YasinC4342/BLE-MacroPad/README.md

# Description
The MacroPad is a general use macro keypad, designed for ECAD, CAD, Photoshop, Blender and many other professionnal softwares. Its purpose is to make multiple combinations within one click, so shortcuts (ex : CTRL + ALT + SHIFT or simply write lots of words). It will be working on both BLE and USB HID.

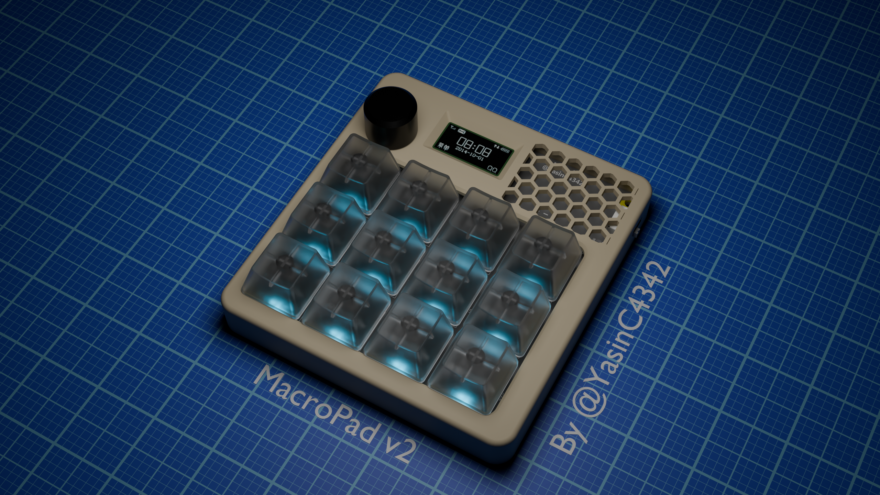
[picture p1: screenshots/rendered.png]


# Why i made this ?

My goal was to make 3D models quickly for the customers who needs it earlier than expected, and also for blender if i ever forgot of which combination i use for making a Bezel for example. Since i have a compact keyboard (about 60-65%), i needed more keys without sacrificing my workspace and also to put it on the side of the desk when i doesn't need it. Anyway, here is my first prototype (i cannot 3d print parts now because I am in the process of moving but as soon as possible) :
Link : [**https://wokwi.com/projects/478323132743048193**](https://wokwi.com/projects/478323132743048193)

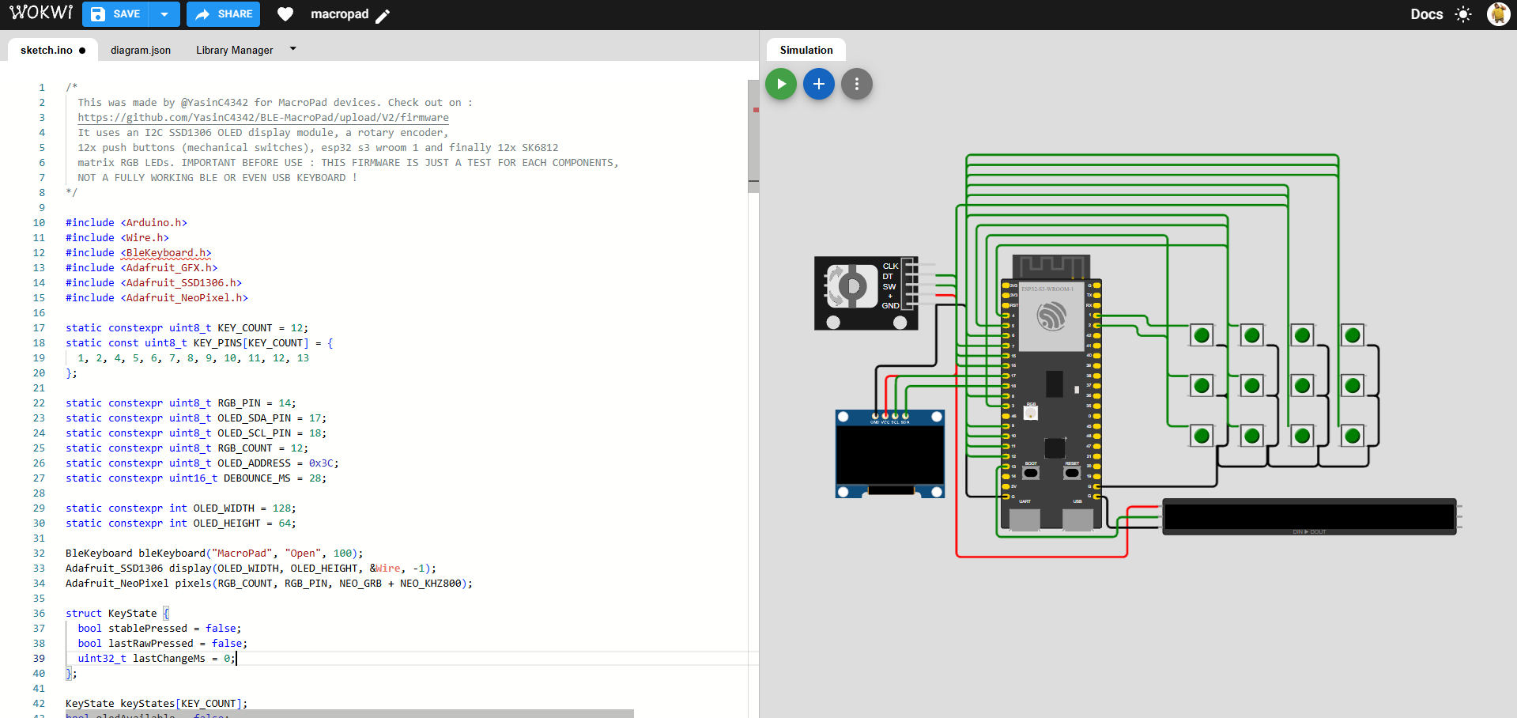
[picture p2: screenshots/prototype.png]


For information, i used examples of the libraries and merge all the examples in one code (with adjustements of course) to see if it works. Unfortunately, i don't own any esp32 but making simulations on Wowki or Tinkercad, so no bluetooth or usb, just basic testing.
 
# Features
- O.96inch OLED display
- 12 adressable RGB LEDs
- 3x4 Cherry MX switches
- USB type C
- Obviously works on bluetooth and USB HID
- A rotary encoder for controling volume with ease, for example.

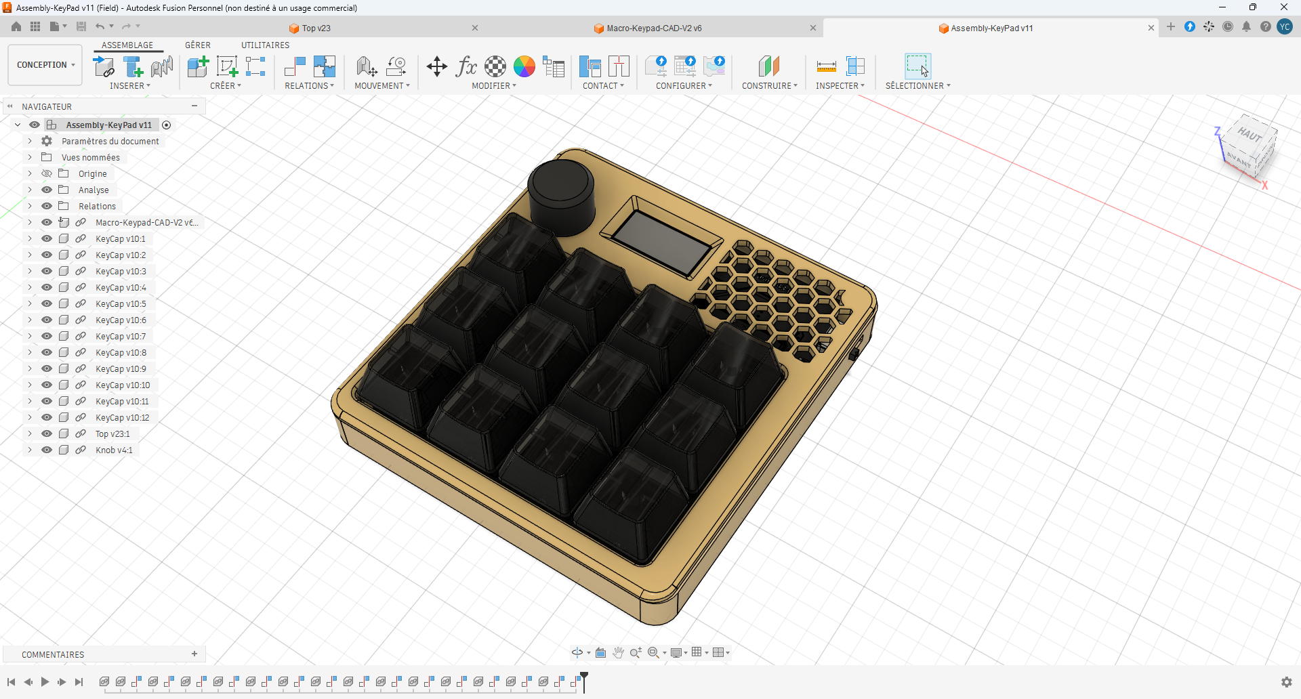
[picture p3: screenshots/cad.png]

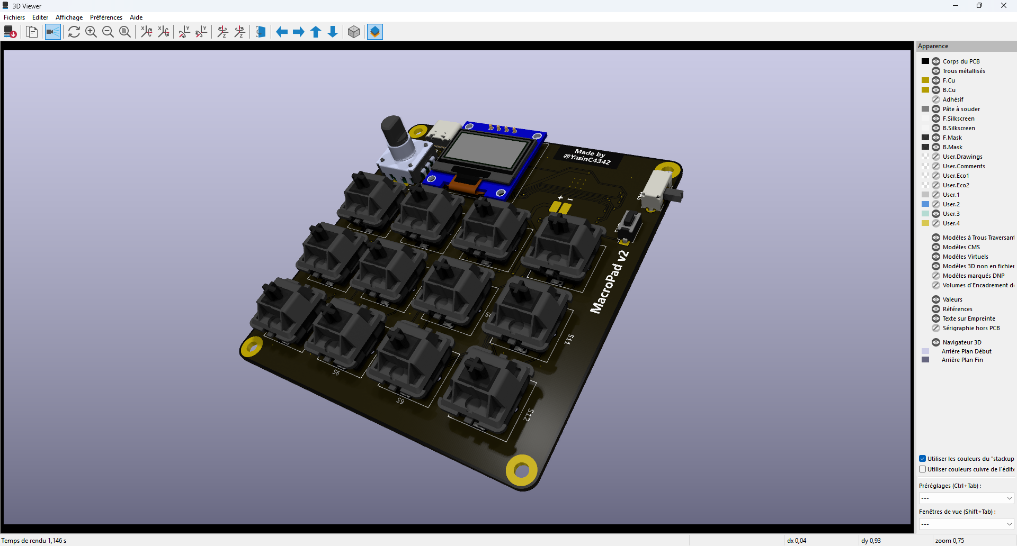
[picture p4: screenshots/pcb.png]

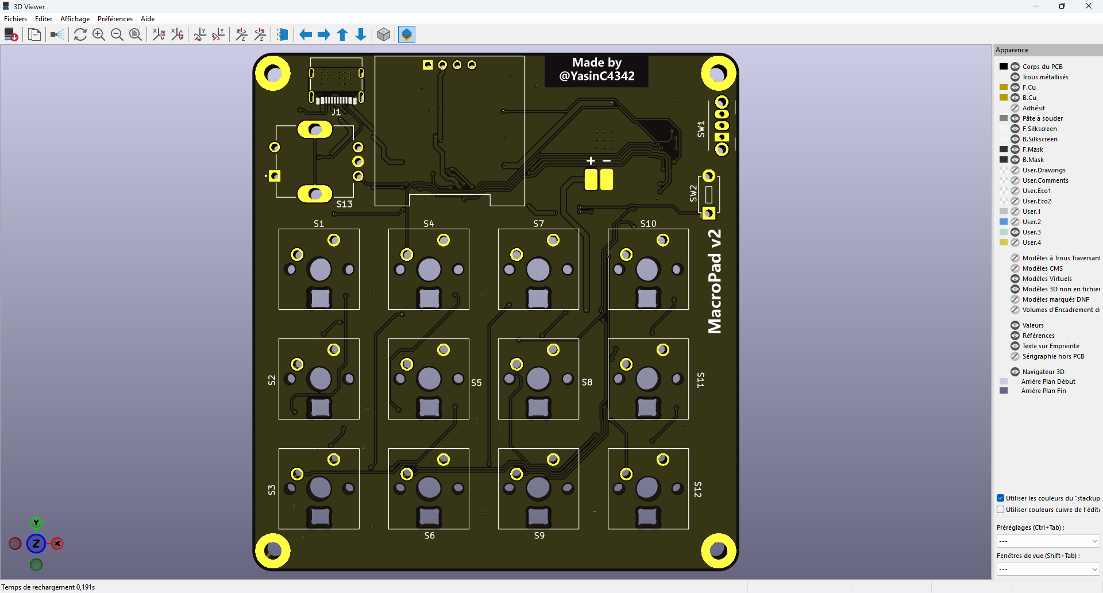
[picture p5: screenshots/front.png]

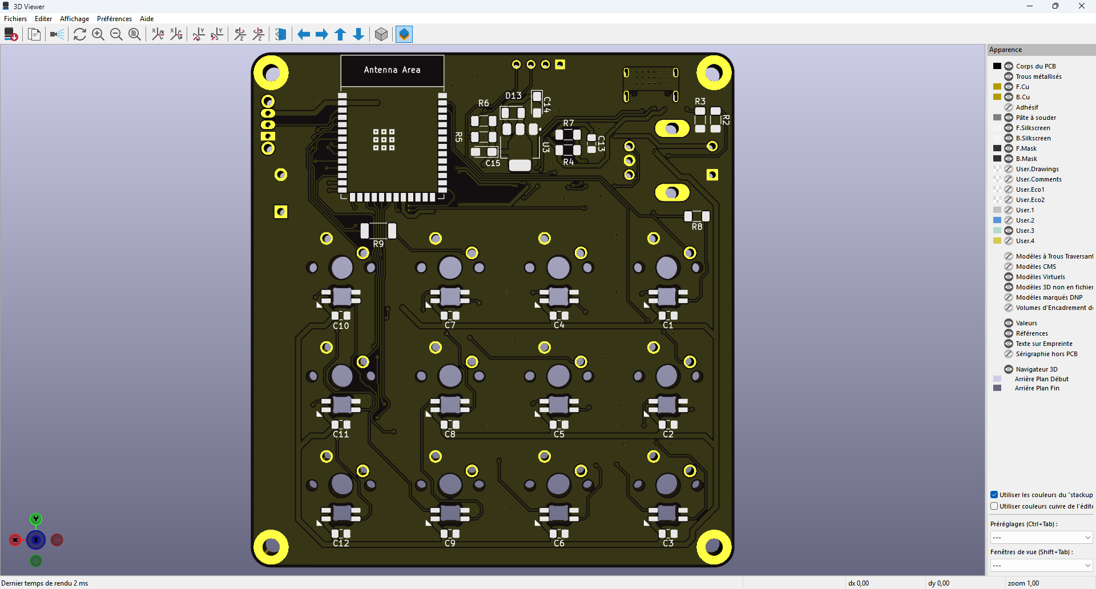
[picture p6: screenshots/back.png]


# Requirements
The required components are down below :

| ID | Reference | Designation | Quantity | Value | Price EUR  | Supplier | Links |
|----|---|---|---|---|---|---|---|
| 1  | C1, C2, C3, C4, C5, C6, C7, C8, C9, C10, C11, C12 | 0805 SMD Capacitor | 12 | 0.1uF | 1,8 € | Aliexpress | [Link](https://www.aliexpress.com/item/1005012588693858.html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)  |
| 2  | C13 | 0805 SMD Capacitor | 1 | 10uF | 1,8 € | Aliexpress | [Link](https://www.aliexpress.com/item/1005012588693858.html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)  |
| 3  | C14 | Tantalum Capacitor, Kemet-A | 1 | 10uF | 1,32 € | Aliexpress | [Link](https://www.aliexpress.com/item/32698733093.html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) |
| 4  | C15 | Tantalum Capacitor, Kemet-A | 1 | 22uF | 1,59 € | Aliexpress | [Link](https://www.aliexpress.com/item/32698733093.html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) |
| 5  | D1, D2, D3, D4, D5, D6, D7, D8, D9, D10, D11, D12 | SK6812 Mini Reversed SMD RGB LEDs | 12 | SK6812 | 4,39 € | Aliexpress | [Link](https://www.aliexpress.com/item/1005005186515165.html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)  |
| 6  | D13 | 1206 SMD Diode | 1 | Diode | - | Aliexpress | **Already own the component** |
| 7  | J1 | USB-C Female connector 12 pin | 1 | USB_C_female_14P | 2,18 € | Aliexpress | [Link](https://www.aliexpress.com/item/1005005371954812.html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)  |
| 8  | R1 | 1206 SMD Resistor | 1 | 470R | 0,95 € | Aliexpress | [Link](https://www.aliexpress.com/item/1005012304341288.html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)  |
| 9  | R2, R3, R5, R6 | 1206 SMD Resistor | 4 | 5.1K | 0,95 € | Aliexpress | [Link](https://www.aliexpress.com/item/1005012304341288.html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)  |
| 10 | R4 | 1206 SMD Resistor | 1 | 10K | 0,95 € | Aliexpress | [Link](https://www.aliexpress.com/item/1005012304341288.html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)  |
| 11 | R7 | 1206 SMD Resistor | 1 | 1.8K | 0,95 € | Aliexpress | [Link](https://www.aliexpress.com/item/1005012304341288.html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)  |
| 12 | R9 | 2010 SMD Resistor | 1 | 0R | - | Aliexpress | **Already own the component** |
| 13 | S1, S2, S3, S4, S5, S6, S7, S8, S9, S10, S11, S12 | Cherry MX1A-11NA Switches | 12 | MX1A-11NA | 5,30 € | Aliexpress | [Link](https://www.aliexpress.com/item/1005008089864080.html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)  |
| 14 | S13 | PEC11R Rotary encoder | 1 | PEC12R_Encoder | 3,99 € | Aliexpress | [Link](https://www.aliexpress.com/item/1005007391341287.html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) |
| 15 | SW1 | SPDT Slide switch | 1 | SW_SPDT | - | Aliexpress | **Already own the component** |
| 16 | SW2 | Push button 6x3.5mm | 1 | SW_Push | 3,59 € | Aliexpress | [Link](https://www.aliexpress.com/item/1005007177692594.html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)  |
| 17 | U1 | ESP32-S3-WROOM-1 | 1 | ESP32-S3-WROOM-1 | 6,59 € | Aliexpress | [Link](https://www.aliexpress.com/item/1005009314619102.html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)  |
| 18 | U2 | 0.96" OLED Display module | 1 | 0,96"  OLED Module | 2,56 € | Aliexpress | [Link](https://www.aliexpress.com/item/1005006141235306.html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)  |
| 20 | PCB | Main PCB | 1 | PCB | 3,57 € | Aliexpress | [Link](https://cart.jlcpcb.com/fr/quote?spm=jlcpcb.Public.2006) 
| **Total** | **43,88 €** | **49,24 $** |

**AI Disclosure:**
During this project, I used AI to help with debugging KiCad DRC errors and to assist in writing firmware, and to check if my circuit is fine WITHOUT listing any components, just giving me advice and i did on my own and figured out later.

For 3d parts, I wiil 3d print them, so not included in the list of shipping or buying.

# Downloads
Download the complete hardware design package from the [**v2.0.0 Release**](https://github.com/YasinC4342/BLE-MacroPad/releases/tag/v2.0.0).
