YasinC4342/BLE-MacroPad/screenshots/cart-1.png

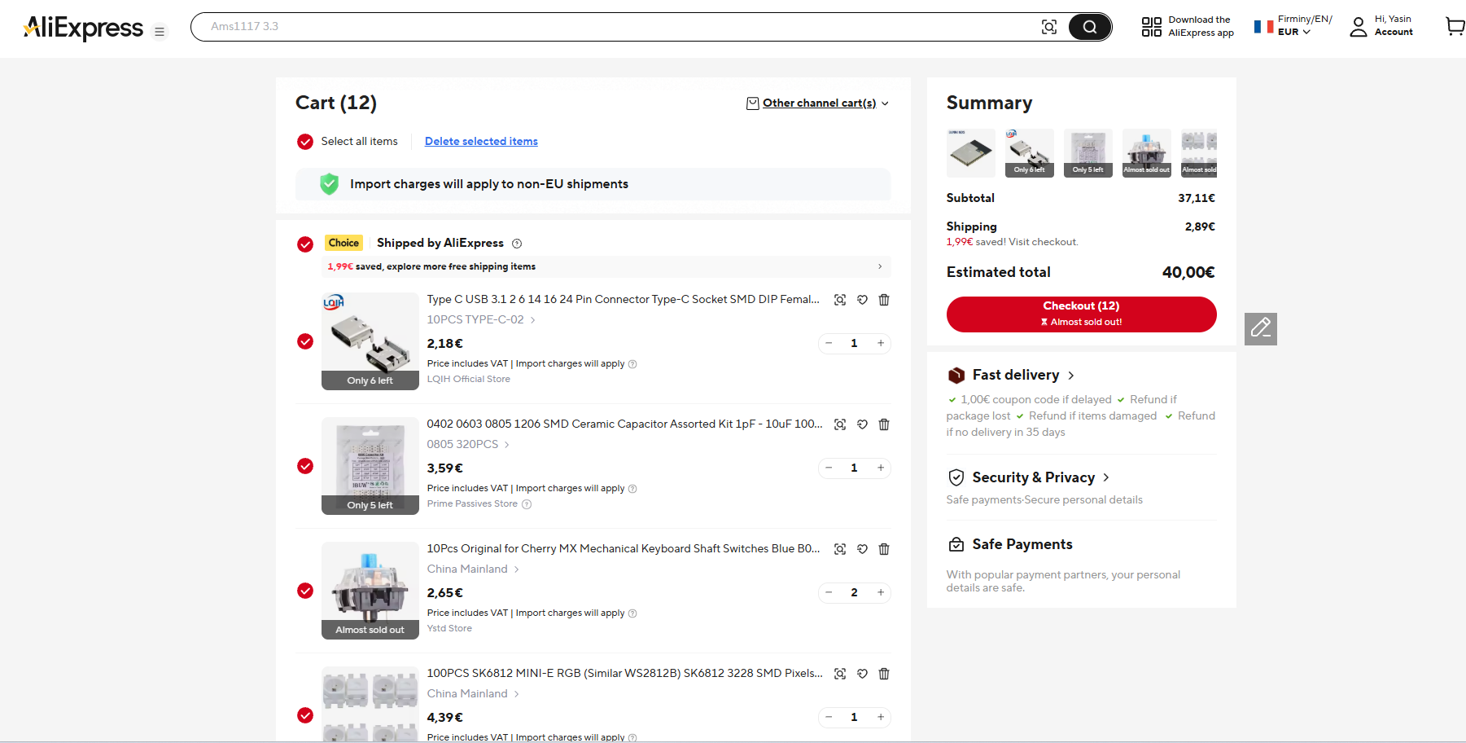
screenshots/cart-1.png
