YasinC4342/BLE-MacroPad/screenshots/cart-2.png

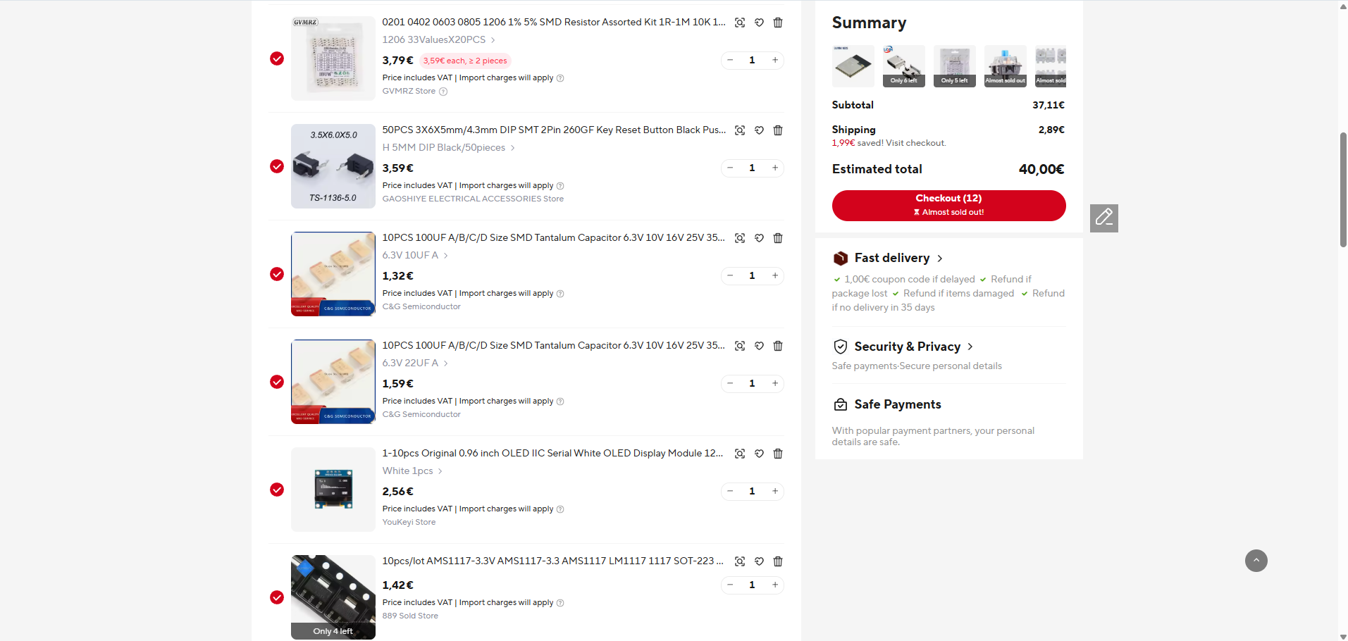
screenshots/cart-2.png
