YasinC4342/BLE-MacroPad/screenshots/cart-3.png

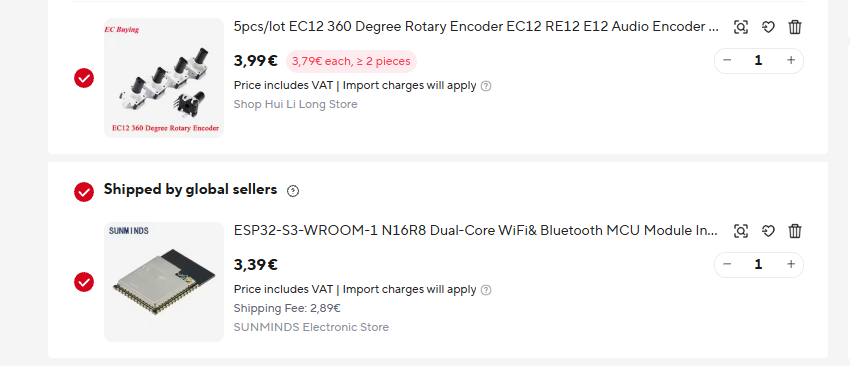
screenshots/cart-3.png
