YasinC4342/BLE-MacroPad/screenshots/DRC.png

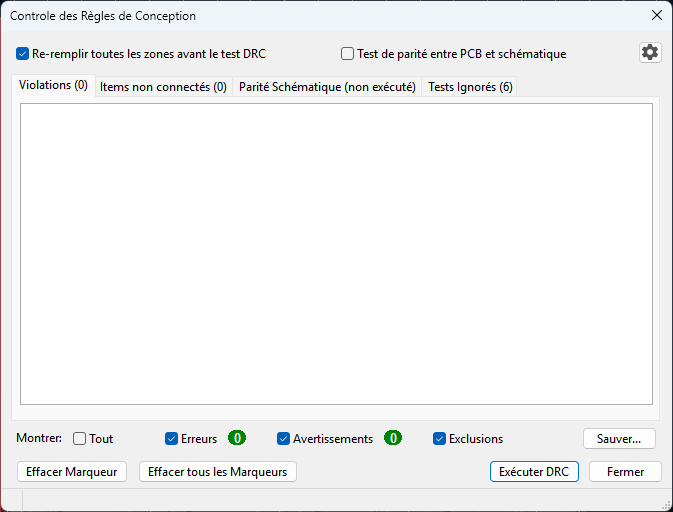
screenshots/DRC.png
