YasinC4342/BLE-MacroPad/screenshots/ERC.png

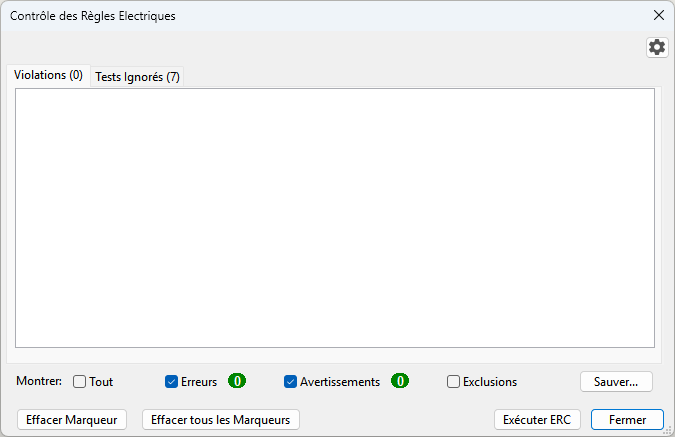
screenshots/ERC.png
