YasinC4342/BLE-MacroPad/screenshots/release.png

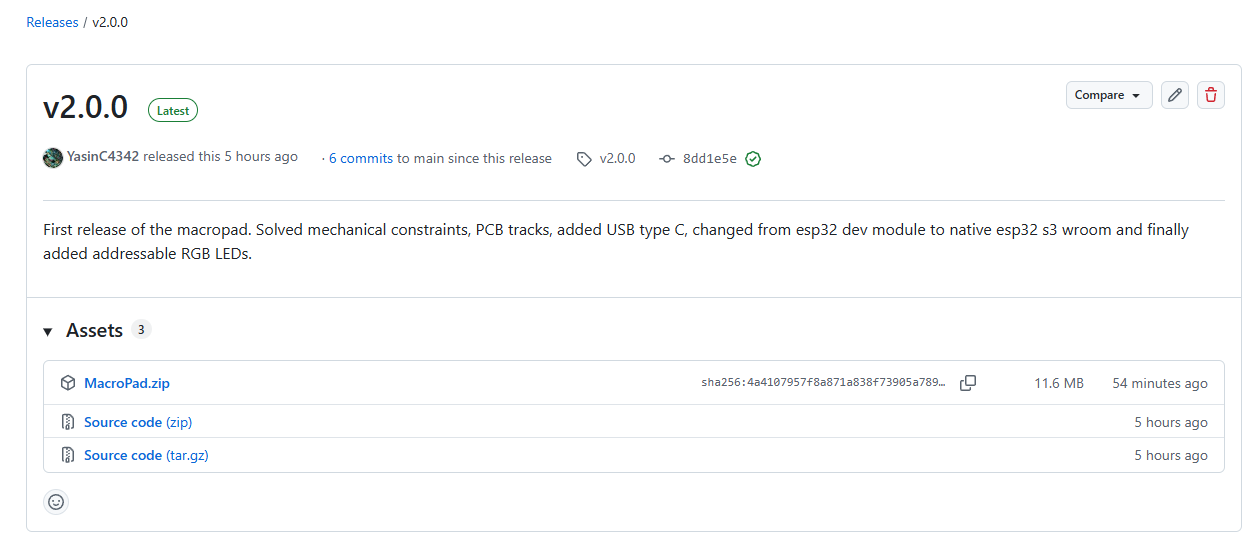
screenshots/release.png
