YasinC4342/BLE-MacroPad/screenshots/schematic.png

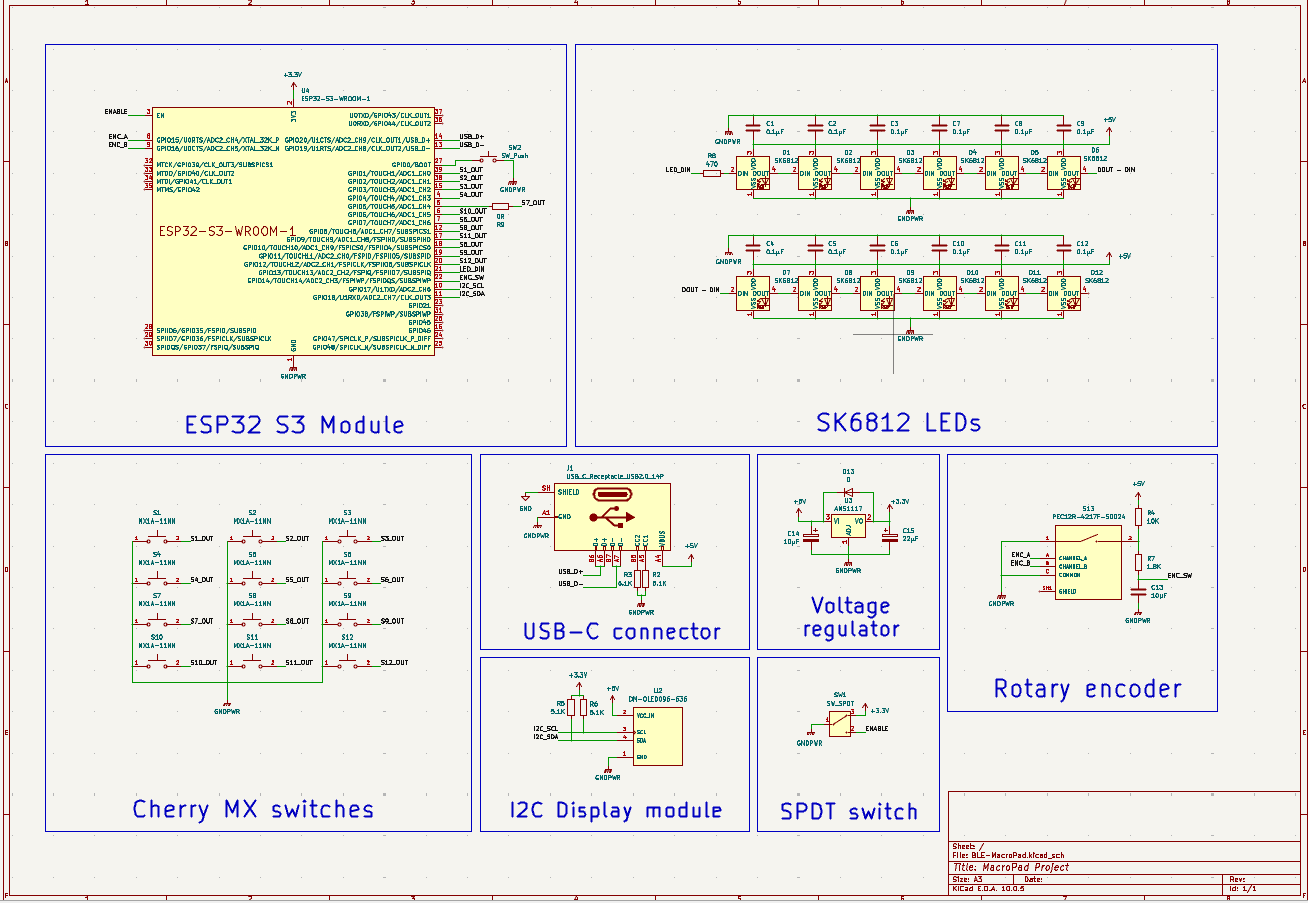
screenshots/schematic.png
