YasinC4342/BLE-MacroPad/screenshots/shop.png

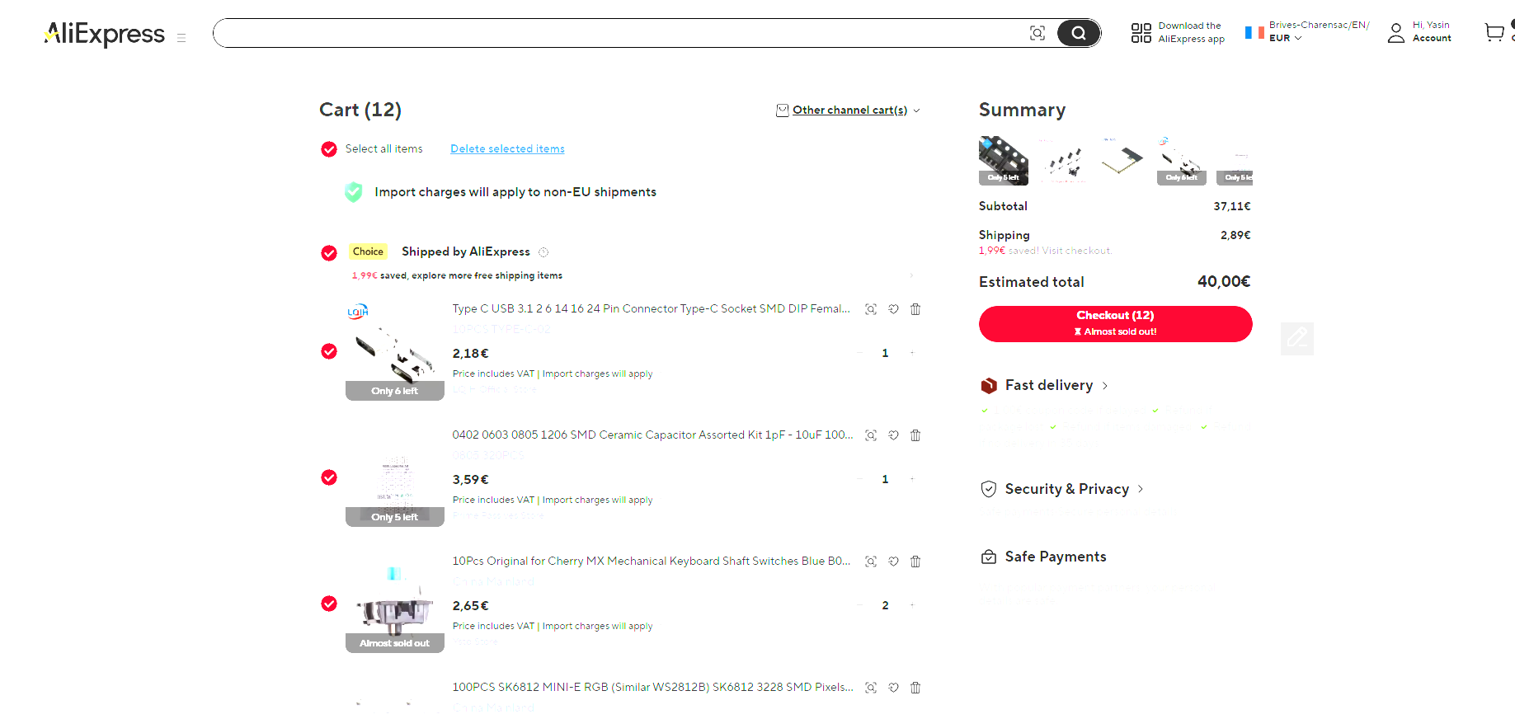
screenshots/shop.png
