YasinC4342/BLE-MacroPad/BOM.csv

ID | Reference | Designation | Quantity | Value | Price EUR | Supplier | Links
1 | C1, C2, C3, C4, C5, C6, C7, C8, C9, C10, C11, C12 | 0805 SMD Capacitor | 12 | 0.1uF | 1,8 € | Aliexpress | https://www.aliexpress.com/item/1005012588693858.html?mp=1
2 | C13 | 0805 SMD Capacitor | 1 | 10uF | 1,8 € | Aliexpress | https://www.aliexpress.com/item/1005012588693858.html?mp=1
3 | C14 | Tantalum Capacitor, Kemet-A | 1 | 10uF | 1,32 € | Aliexpress | https://www.aliexpress.com/item/32698733093.html?mp=1
4 | C15 | Tantalum Capacitor, Kemet-A | 1 | 22uF | 1,59 € | Aliexpress | https://www.aliexpress.com/item/32698733093.html?mp=1
5 | D1, D2, D3, D4, D5, D6, D7, D8, D9, D10, D11, D12 | SK6812 Mini Reversed SMD RGB LEDs | 12 | SK6812 | 4,39 € | Aliexpress | https://www.aliexpress.com/item/1005005186515165.html?mp=1
6 | D13 | 1206 SMD Diode | 1 | Diode | - | Aliexpress | Already own the component
7 | J1 | USB-C Female connector 12 pin | 1 | USB_C_female_14P | 2,18 € | Aliexpress | https://www.aliexpress.com/item/1005005371954812.html?mp=1
8 | R1 | 1206 SMD Resistor | 1 | 470R | 0,95 € | Aliexpress | https://www.aliexpress.com/item/1005012304341288.html?mp=1
9 | R2, R3, R5, R6 | 1206 SMD Resistor | 4 | 5.1K | 0,95 € | Aliexpress | https://www.aliexpress.com/item/1005012304341288.html?mp=1
10 | R4 | 1206 SMD Resistor | 1 | 10K | 0,95 € | Aliexpress | https://www.aliexpress.com/item/1005012304341288.html?mp=1
11 | R7 | 1206 SMD Resistor | 1 | 1.8K | 0,95 € | Aliexpress | https://www.aliexpress.com/item/1005012304341288.html?mp=1
12 | R9 | 2010 SMD Resistor | 1 | 0R | - | Aliexpress | Already own the component
13 | S1, S2, S3, S4, S5, S6, S7, S8, S9, S10, S11, S12 | Cherry MX1A-11NA Switches | 12 | MX1A-11NA | 5,30 € | Aliexpress | https://www.aliexpress.com/item/1005008089864080.html?mp=1
14 | S13 | PEC11R Rotary encoder | 1 | PEC12R_Encoder | 3,99 € | Aliexpress | https://www.aliexpress.com/item/1005007391341287.html?mp=1
15 | SW1 | SPDT Slide switch | 1 | SW_SPDT | - | Aliexpress | Already own the component
16 | SW2 | Push button 6x3.5mm | 1 | SW_Push | 3,59 € | Aliexpress | https://www.aliexpress.com/item/1005007177692594.html?mp=1
17 | U1 | ESP32-S3-WROOM-1 | 1 | ESP32-S3-WROOM-1 | 6,59 € | Aliexpress | https://www.aliexpress.com/item/1005009314619102.html?mp=1
18 | U2 | 0.96" OLED Display module | 1 | 0,96" OLED Module | 2,56 € | Aliexpress | https://www.aliexpress.com/item/1005006141235306.html?mp=1
20 | PCB | Main PCB | 1 | PCB | 3,57 € | Aliexpress | https://cart.jlcpcb.com/fr/quote?spm=jlcpcb.Public.2006
TOTAL | 43,88 € | 49,24 $
