YasinC4342/BLE-MacroPad/list-of-components.xlsx

ID | Reference | Footprint | Quantity | Designation | Price Euro | Links | TOTAL Euro
1 | C1, C2, C3, C4, C5, C6, C7, C8, C9, C10, C11, C12 | C_0805_2012Metric_Pad1.18x1.45mm_HandSolder | 12 | 0.1uF | 1.795 | https://www.aliexpress.com/item/1005012588693858.html?mp=1 | 40.31
2 | C13 | C_0805_2012Metric_Pad1.18x1.45mm_HandSolder | 1 | 10uF | 1.795 | https://www.aliexpress.com/item/1005012588693858.html?mp=1 | 0 euro = already have components
3 | C14 | CP_EIA-3216-18_Kemet-A_HandSolder | 1 | 10uF | 1.32 | https://www.aliexpress.com/item/32698733093.html?mp=1
4 | C15 | CP_EIA-3216-18_Kemet-A_HandSolder | 1 | 22uF | 1.59 | https://www.aliexpress.com/item/32698733093.html?mp=1 | PCB : 3,57 euro
5 | D1, D2, D3, D4, D5, D6, D7, D8, D9, D10, D11, D12 | MX_SK6812MINI-E | 12 | SK6812 | 4.39 | https://www.aliexpress.com/item/1005005186515165.html?mp=1
6 | D13 | D_1206_3216Metric | 1 | Diode | 0
7 | J1 | USB_C_Receptacle_Palconn_UTC16-G | 1 | USB_C_female_14P | 2.18 | https://www.aliexpress.com/item/1005005371954812.html?mp=1
8 | R1 | R_1206_3216Metric_Pad1.30x1.75mm_HandSolder | 1 | 470R | 0.9475 | https://www.aliexpress.com/item/1005012304341288.html?mp=1
9 | R2, R3, R5, R6 | R_1206_3216Metric_Pad1.30x1.75mm_HandSolder | 4 | 5.1K | 0.9475
10 | R4 | R_1206_3216Metric_Pad1.30x1.75mm_HandSolder | 1 | 10K | 0.9475
11 | R7 | R_1206_3216Metric_Pad1.30x1.75mm_HandSolder | 1 | 1.8K | 0.9475
12 | R9 | R_2010_5025Metric_Pad1.40x2.65mm_HandSolder | 1 | 0R | 0
13 | S1, S2, S3, S4, S5, S6, S7, S8, S9, S10, S11, S12 | SW_Cherry_MX_1.00u_PCB | 12 | MX1A-11NA | 5.3 | https://www.aliexpress.com/item/1005008089864080.html?mp=1
14 | S13 | XDCR_PEC12R-4217F-S0024 | 1 | PEC12R_Encoder | 3.99 | https://www.aliexpress.com/item/1005007391341287.html?mp=1
15 | SW1 | SW_Slide_SPDT_Angled_CK_OS102011MA1Q | 1 | SW_SPDT | 0
16 | SW2 | SW_PUSH_1P1T_6x3.5mm_H5.0_APEM_MJTP1250 | 1 | SW_Push | 3.59 | https://www.aliexpress.com/item/1005007177692594.html?mp=1
17 | U1 | ESP32-S3-WROOM-1 | 1 | ESP32-S3-WROOM-1 | 6.59 | https://www.aliexpress.com/item/1005009314619102.html?mp=1
18 | U2 | MODULE_DM-OLED096-636 | 1 | 0,96" OLED Module | 2.56 | https://www.aliexpress.com/item/1005006141235306.html?mp=1
19 | U3 | SOT-223-3_TabPin2 | 1 | AMS1117-3.3 | 1.42 | https://www.aliexpress.com/item/1005007500541919.html?mp=1
