YasinC4342/BLE-MacroPad/screenshots/bom.png

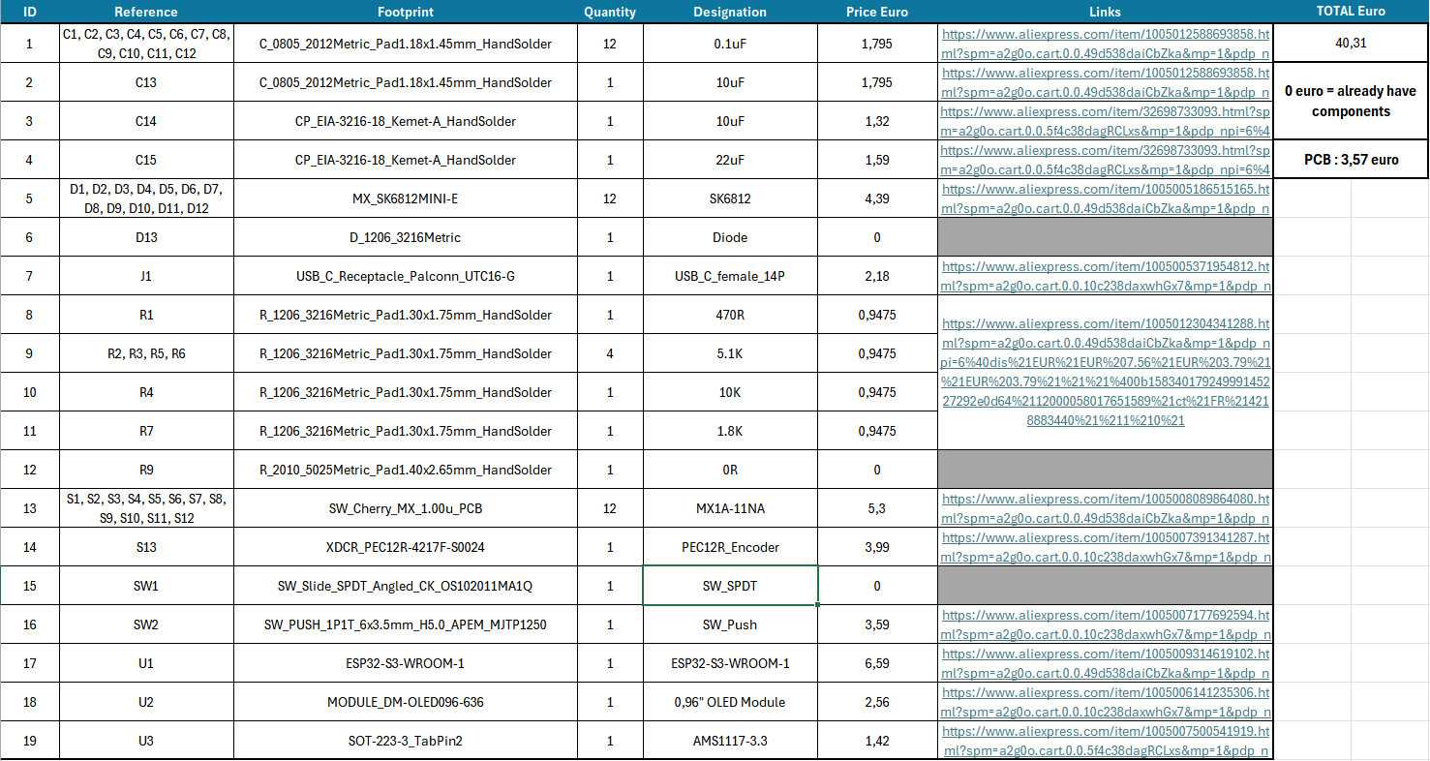
screenshots/bom.png
