YasinC4342/BLE-MacroPad/CAD/Top.step

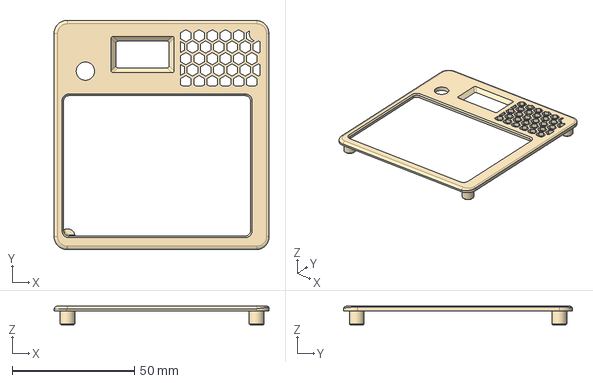
[picture p16: CAD file, 2026-10-17]
CAD/Top.step
88.0 x 93.9 x 7.70 mm
