YasinC4342/BLE-MacroPad/CAD/Base.step

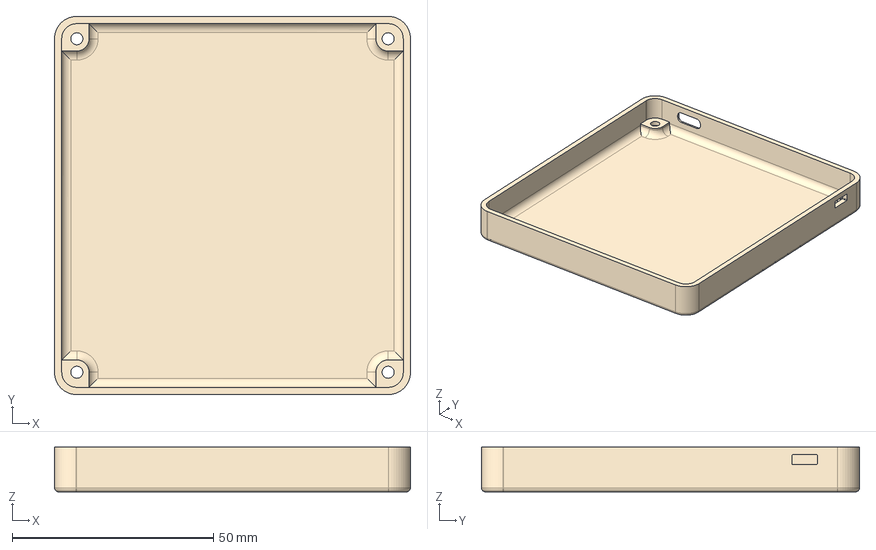
[picture p17: CAD file, 2026-10-17]
CAD/Base.step
88.5 x 94.0 x 11.1 mm
