YasinC4342/BLE-MacroPad/CAD/Knob.step

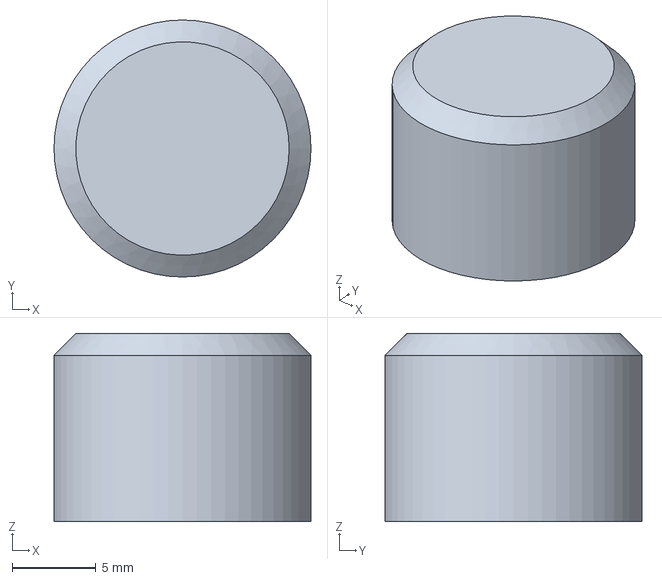
[picture p18: CAD file, 2026-10-17]
CAD/Knob.step
15.3 x 15.3 x 11.2 mm
