YasinC4342/BLE-MacroPad/CAD/BLE-MacroPad.step

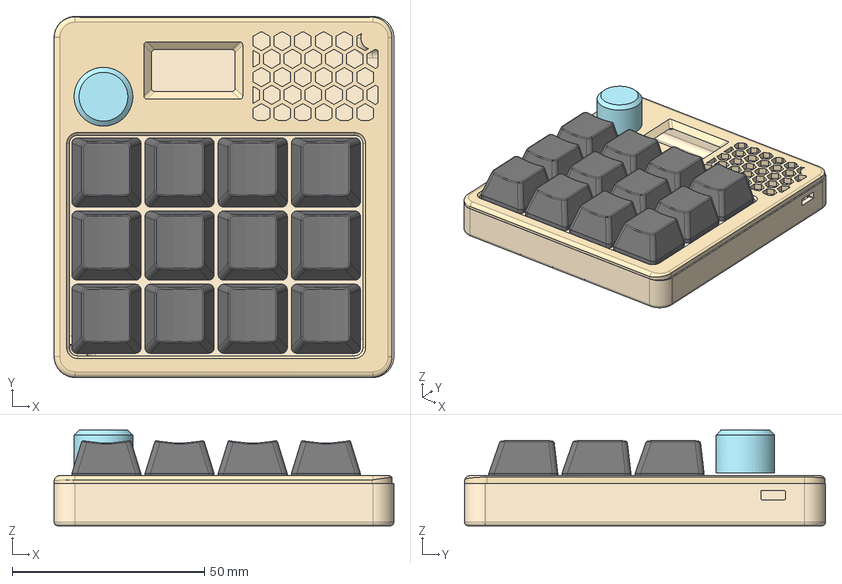
[picture p19: CAD file, 2026-10-17]
CAD/BLE-MacroPad.step
88.5 x 94.0 x 24.9 mm
Macro-Keypad-CAD-V2
KeyCap x 12
Top
Knob
