YasinC4342/BLE-MacroPad/(list of files, cad)

Other CAD files:
CAD/BLE-MacroPad.f3z
CAD/BLE-MacroPad.stl
CAD/Base.stl
CAD/Knob.stl
CAD/Top.stl
