YasinC4342/BLE-MacroPad/screenshots/manufacture.png

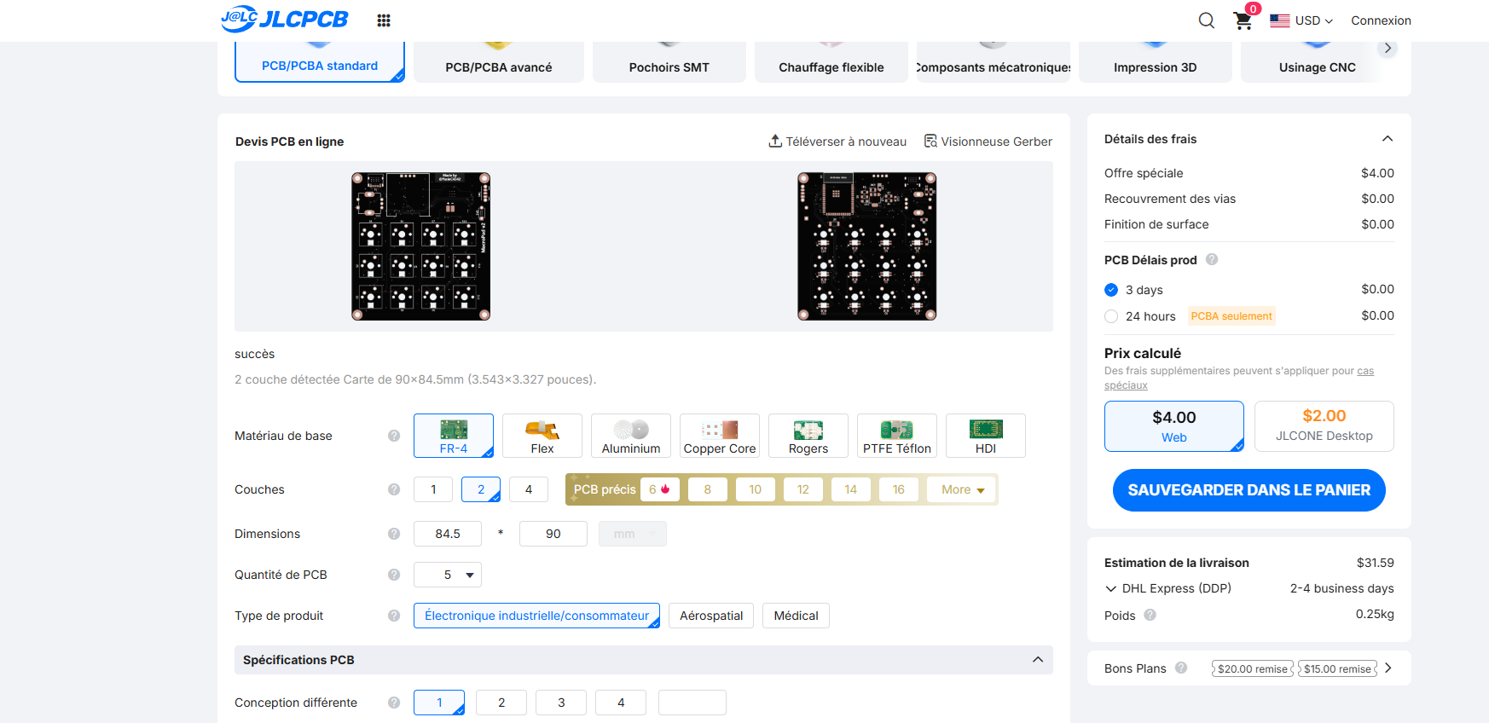
screenshots/manufacture.png
