YasinC4342/BLE-MacroPad/JOURNAL.md

---
title: "BLE-MacroPad"
github: "https://github.com/YasinC4342/BLE-MacroPad"
description: "A custom Bluetooth macro keypad for CAD, ECAD, and professional software."
created_at: "2026-10-17"
total_time: "13h 6m"
---

# BLE-MacroPad — Project Journal

The MacroPad is a general use macro keypad, designed for ECAD, CAD, Photoshop, Blender and many other professionnal softwares. Its purpose is to make multiple combinations within one click, so shortcuts (ex : CTRL + ALT + SHIFT or simply write lots of words). It will be working on both BLE and USB HID.

# October 1, 2026: PCB Design in KiCad
<!-- fabricate:entry 758 -->

I made the PCB in KiCad, integrating the ESP32-S3-WROOM-1 module, mechanical switches, RGB LEDs, OLED display module, and USB-C connector, with the PCB dimension of about 75 × 77 mm. ERC and DRC checks passed successfully.
I added a keepout zone around the ESP32 antenna area to reduce EMI, perturbating noises and also for better Bluetooth cover range, helped from documentations of Espressif. My goal was to fit all the components into a compact PCB to make it portable, not taking the majority of the workspace, keep the antenna's edge on the edge cuts of the PCB, chose differents tracks width and for only 2 layers if a problem appears.

**Images**








**Total time spent: 4h 48m**

# October 6, 2026: Mechanical Design and Component Layout
<!-- fabricate:entry 759 -->

I designed the macro keypad 3D model in Fusion 360, integrating 12 keys in a 3×4 layout, an OLED display, RGB LEDs, and a USB Type-C connector.
I imported the .STEP of the PCB and used the tool "Project" to see the exact measurements. But one big problem is that i needed to update it a lot because of the tolerance, which is +- 0.2-0.3, and the spacing between the 3d model's hole for fitting keys and the keycaps. So i used constraints and made it much easier !

I chose Fusion 360 as a CAD software because it's for makers (my thoughts), i have lots of experiences since i love learning some makers softwares and so inspired to them, 
like Abrège : [**https://www.youtube.com/@Abr%C3%A8ge**](https://www.youtube.com/@Abr%C3%A8ge).

**Images**




**Total time spent: 3h**

# October 14, 2026: Preparing the Manufacturing Files
<!-- fabricate:entry 760 -->

I prepared the manufacturing files into a zip for release v2.0.0 on GitHub, including Gerber file, BOM, and mechanical exports. So i exported the Gerber and BOM from KiCAD and tested on JLCPCB to see the 3d/2d view of the pcb and detection of the pcb, and of course i choose the cheapest delivery method to fit in my budget from 29$ to 4$ total. I chose black mask and white silkscreen to make it professionnal, remarquable and also to make it look like modern and newest design. All the files are ready, organised in the main directory and BOM updated, and I will publish the documentation of the product when received, assembled and tested.

**Project release**

[BLE-MacroPad v2.0.0 — Manufacturing Package](https://github.com/YasinC4342/BLE-MacroPad/releases/tag/v2.0.0)

**Images**




**Total time spent: 30m**

# October 20, 2026: Component Cost Optimization
<!-- fabricate:entry 761 -->

After realising that the project exceeds the max amount of 50$, I updated the BOM to reduce cost and stay in the 50$ budget (tier 4). The ESP32-S3-WROOM-2 was too expensive, so I decided to replace it and instead choose the ESP32-S3-WROOM-1 N16R8, more affordable in Aliexpress. After those changes, I updated the PCB footprint / symbol, replacing it, and checked the tracks (routing), antenna area and positionning, and ERC/DRC results before generating the final manufacturing files. And so this costs at a total amount of about 49$, including shipping and all of those stuffs, which i will round it to 50$.

**Images**






**Total time spent: 4h 48m**
