YasinC4342/BLE-MacroPad/PCB/BLE-MacroPad.kicad_pcb

## KiCad design PCB/BLE-MacroPad.kicad_pcb (2026-10-20)

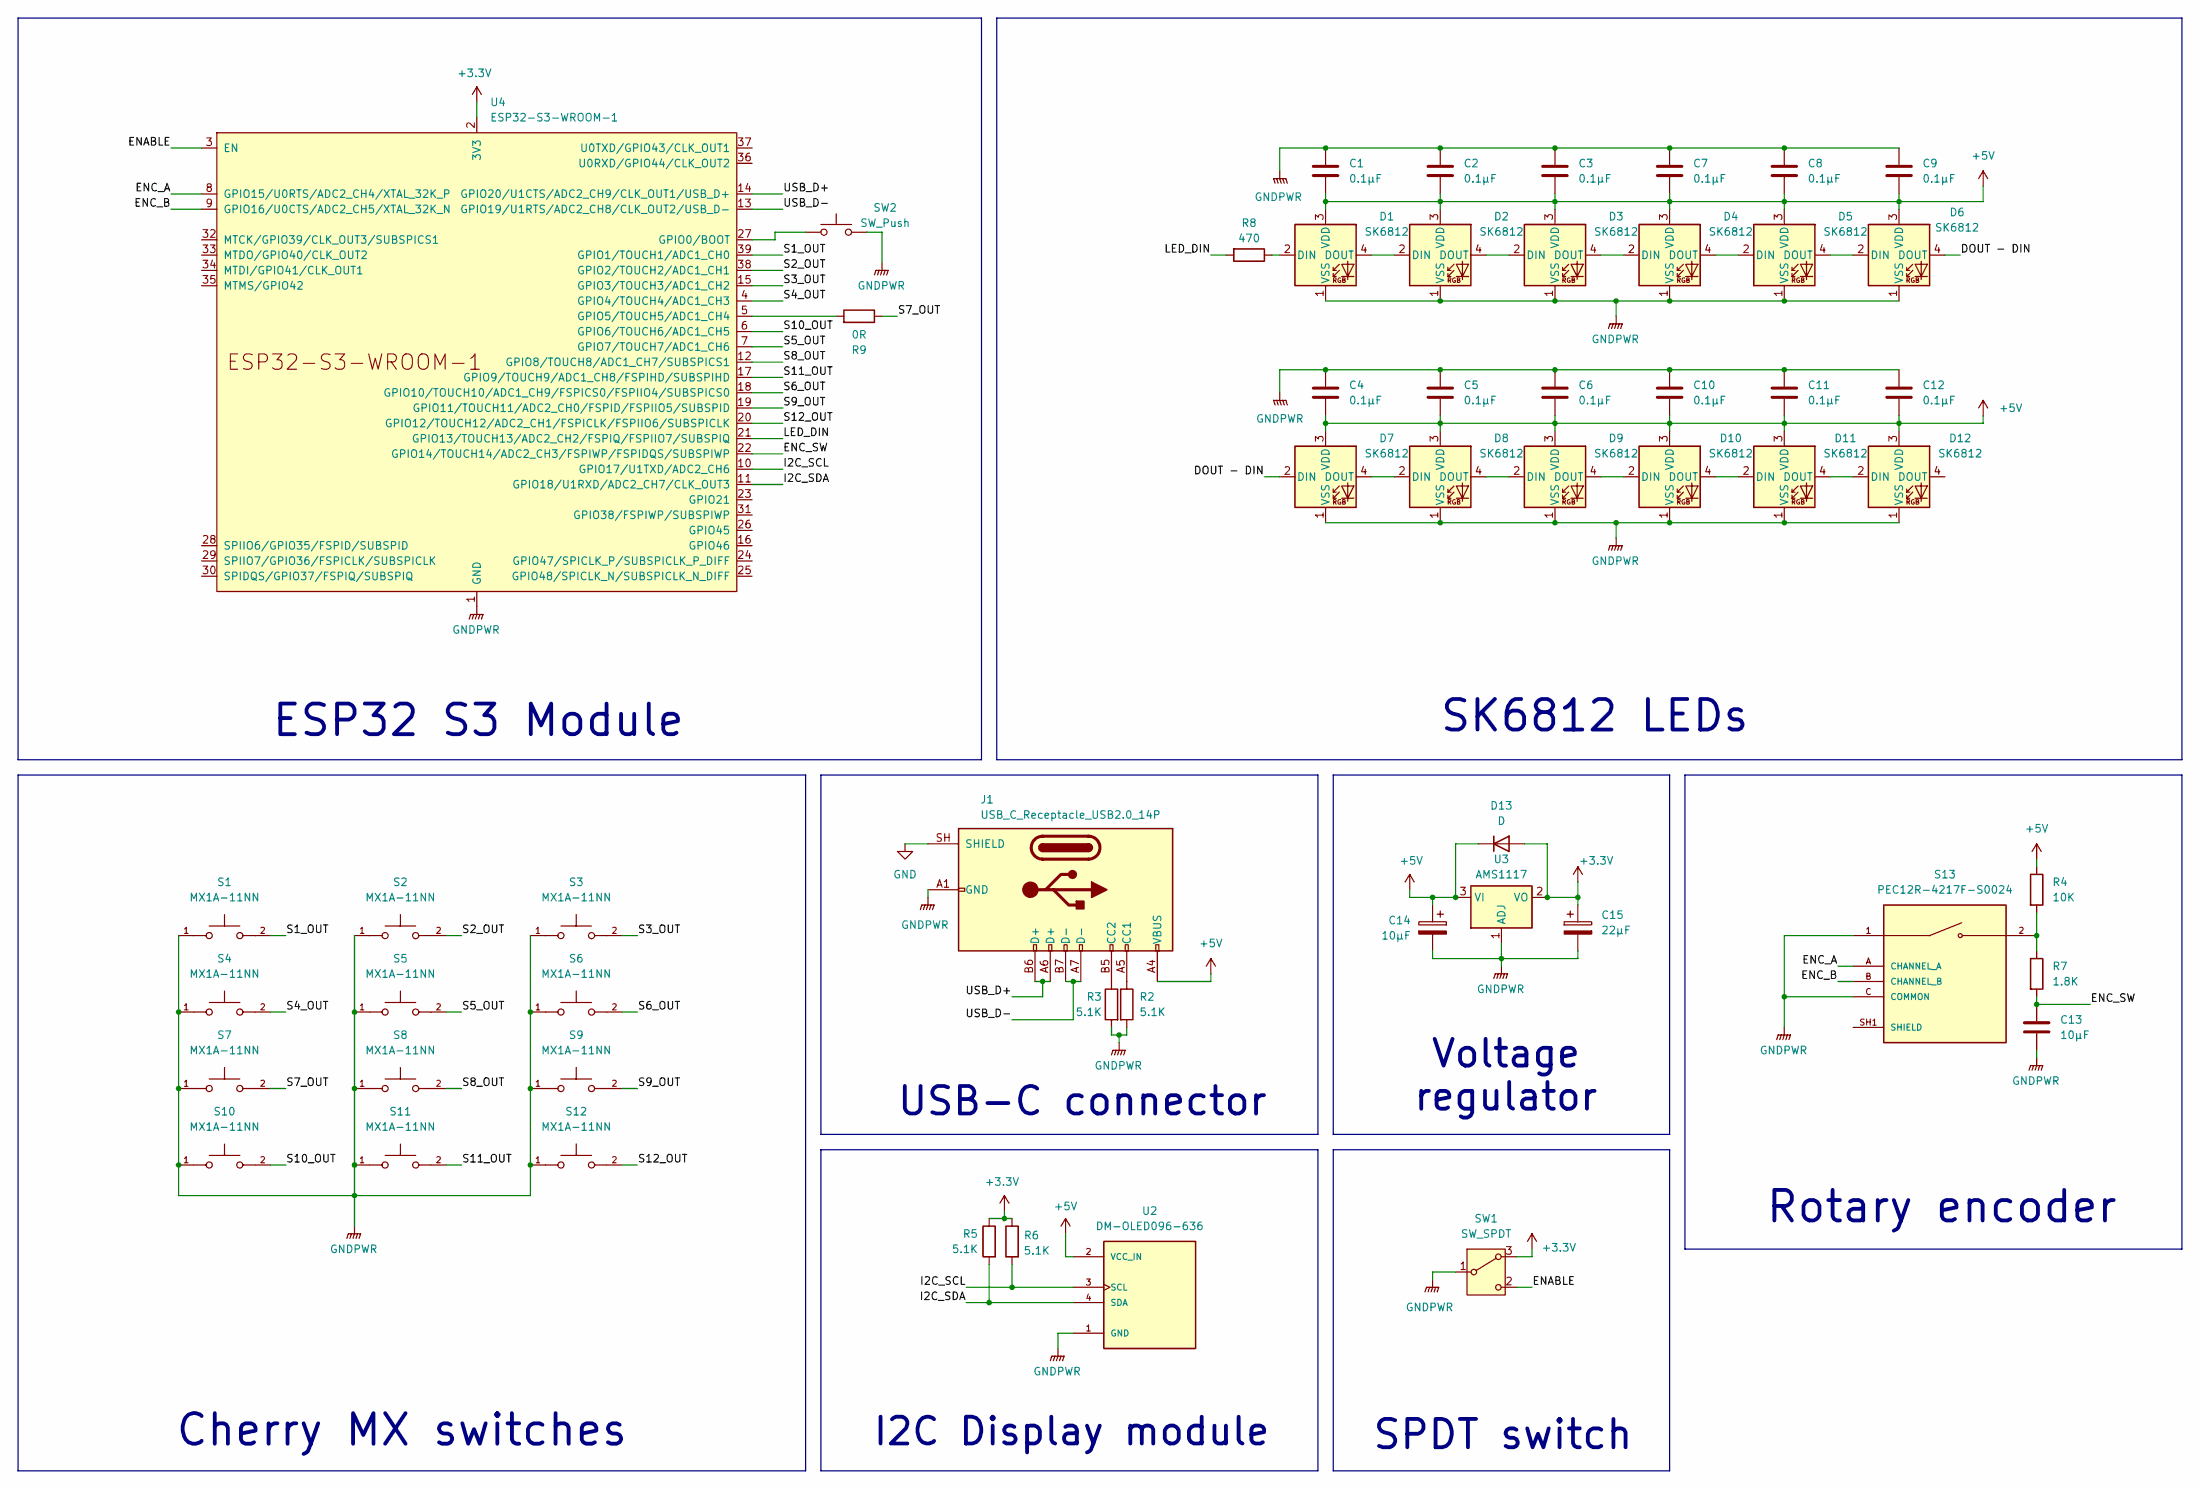
[picture p21: schematic BLE-MacroPad.kicad_sch, MacroPad Project]

Parts:
C1, C2, C3, C4, C5, C6, C7, C8, C9, C10, C11, C12: 0.1µF; C_0805_2012Metric_Pad1.18x1.45mm_HandSolder
C13: 10µF; C_0805_2012Metric_Pad1.18x1.45mm_HandSolder
C14: 10µF; CP_EIA-3216-18_Kemet-A_HandSolder
C15: 22µF; CP_EIA-3216-18_Kemet-A_HandSolder
D1, D2, D3, D4, D5, D6, D7, D8, D9, D10, D11, D12: SK6812; MX_SK6812MINI-E
D13: D; D_1206_3216Metric
J1: USB_C_Receptacle_USB2.0_14P; USB_C_Receptacle_Palconn_UTC16-G
R2, R3, R5, R6: 5.1K; R_1206_3216Metric_Pad1.30x1.75mm_HandSolder
R4: 10K; R_1206_3216Metric_Pad1.30x1.75mm_HandSolder
R7: 1.8K; R_1206_3216Metric_Pad1.30x1.75mm_HandSolder
R8: 470; R_1206_3216Metric_Pad1.30x1.75mm_HandSolder
R9: 0R; R_2010_5025Metric_Pad1.40x2.65mm_HandSolder
S1, S2, S3, S4, S5, S6, S7, S8, S9, S10, S11, S12: MX1A-11NN; SW_Cherry_MX_1.00u_PCB
S13: PEC12R-4217F-S0024; XDCR_PEC12R-4217F-S0024
SW1: SW_SPDT; SW_Slide_SPDT_Angled_CK_OS102011MA1Q
SW2: SW_Push; SW_PUSH_1P1T_6x3.5mm_H5.0_APEM_MJTP1250
U2: DM-OLED096-636; MODULE_DM-OLED096-636
U3: AMS1117; SOT-223-3_TabPin2
U4: ESP32-S3-WROOM-1

Connections:
+3.3V: C15.1, D13.2 (A), R5.1, R6.1, SW1.3 (A), U3.2 (VO), U4.2 (3V3)
+5V: C1.2, C2.2, C3.2, C4.2, C5.2, C6.2, C7.2, C8.2, C9.2, C10.2, C11.2, C12.2, C14.1, D1.3 (VDD), D2.3 (VDD), D3.3 (VDD), D4.3 (VDD), D5.3 (VDD), D6.3 (VDD), D7.3 (VDD), D8.3 (VDD), D9.3 (VDD), D10.3 (VDD), D11.3 (VDD), D12.3 (VDD), D13.1 (K), J1.A4 (VBUS), J1.A9 (VBUS), J1.B4 (VBUS), J1.B9 (VBUS), R4.1, U2.2 (VCC_IN), U3.3 (VI); also elsewhere on the board
/DOUT - DIN: D6.4 (DOUT), D7.2 (DIN)
/ENABLE: SW1.2 (C), U4.3 (EN)
/ENC_A: S13.A (CHANNEL_A), U4.8 (GPIO15/U0RTS/ADC2_CH4/XTAL_32K_P)
/ENC_B: S13.B (CHANNEL_B), U4.9 (GPIO16/U0CTS/ADC2_CH5/XTAL_32K_N)
/ENC_SW: C13.1, R7.2, U4.22 (GPIO14/TOUCH14/ADC2_CH3/FSPIWP/FSPIDQS/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)
/I2C_SCL: R6.2, U2.3 (SCL), U4.10 (GPIO17/U1TXD/ADC2_CH6)
/I2C_SDA: R5.2, U2.4 (SDA), U4.11 (GPIO18/U1RXD/ADC2_CH7/CLK_OUT3)
/LED_DIN: R8.2, U4.21 (GPIO13/TOUCH13/ADC2_CH2/FSPIQ/FSPIIO7/S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)
/S1_OUT: S1.2, U4.39 (GPIO1/TOUCH1/ADC1_CH0)
/S2_OUT: S2.2, U4.38 (GPIO2/TOUCH2/ADC1_CH1)
/S3_OUT: S3.2, U4.15 (GPIO3/TOUCH3/ADC1_CH2)
/S4_OUT: S4.2, U4.4 (GPIO4/TOUCH4/ADC1_CH3)
/S5_OUT: S5.2, U4.7 (GPIO7/TOUCH7/ADC1_CH6)
/S6_OUT: S6.2, U4.18 (GPIO10/TOUCH10/ADC1_CH9/FSPICS0/FSPIIO4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)
/S7_OUT: R9.1, S7.2
/S8_OUT: S8.2, U4.12 (GPIO8/TOUCH8/ADC1_CH7/SUBSPICS1)
/S9_OUT: S9.2, U4.19 (GPIO11/TOUCH11/ADC2_CH0/FSPID/FSPIIO5/S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)
/S10_OUT: S10.2, U4.6 (GPIO6/TOUCH6/ADC1_CH5)
/S11_OUT: S11.2, U4.17 (GPIO9/TOUCH9/ADC1_CH8/FSPIHD/SUBSPIHD)
/S12_OUT: S12.2, U4.20 (GPIO12/TOUCH12/ADC2_CH1/FSPICLK/FSPIIO6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)
/USB_D+: J1.A6 (D+), J1.B6 (D+), U4.14 (GPIO20/U1CTS/ADC2_CH9/CLK_OUT1/USB_D+)
/USB_D-: J1.A7 (D-), J1.B7 (D-), U4.13 (GPIO19/U1RTS/ADC2_CH8/CLK_OUT2/USB_D-)
GND: J1.SH (SHIELD)
GNDPWR: C1.1, C2.1, C3.1, C4.1, C5.1, C6.1, C7.1, C8.1, C9.1, C10.1, C11.1, C12.1, C13.2, C14.2, C15.2, D1.1 (VSS), D2.1 (VSS), D3.1 (VSS), D4.1 (VSS), D5.1 (VSS), D6.1 (VSS), D7.1 (VSS), D8.1 (VSS), D9.1 (VSS), D10.1 (VSS), D11.1 (VSS), D12.1 (VSS), J1.A1 (GND), J1.A12 (GND), J1.B1 (GND), J1.B12 (GND), R2.2, R3.2, S1.1, S2.1, S3.1, S4.1, S5.1, S6.1, S7.1, S8.1, S9.1, S10.1, S11.1, S12.1, S13.1, S13.C (COMMON), SW1.1 (B), SW2.2, U2.1 (GND), U3.1 (ADJ), U4.1 (GND), U4.40 (GND), U4.41 (GND); also elsewhere on the board
unnamed: D1.2 (DIN), R8.1
unnamed: D1.4 (DOUT), D2.2 (DIN)
unnamed: D2.4 (DOUT), D3.2 (DIN)
unnamed: D3.4 (DOUT), D4.2 (DIN)
unnamed: D4.4 (DOUT), D5.2 (DIN)
unnamed: D5.4 (DOUT), D6.2 (DIN)
unnamed: D7.4 (DOUT), D8.2 (DIN)
unnamed 33: D8.4 (DOUT), D9.2 (DIN); also elsewhere on the board
unnamed 34: D9.4 (DOUT), D10.2 (DIN); also elsewhere on the board
unnamed: D10.4 (DOUT), D11.2 (DIN)
unnamed: D11.4 (DOUT), D12.2 (DIN)
unnamed: J1.A5 (CC1), R2.1
unnamed: J1.B5 (CC2), R3.1
unnamed: R4.2, R7.1, S13.2
unnamed: S13.SH1 (SHIELD), S13.SH2 (SHIELD)
unnamed: SW2.1, U4.27 (GPIO0/BOOT)
unnamed: R9.2, U4.5 (GPIO5/TOUCH5/ADC1_CH4)

Notes on the sheet:
ESP32 S3 Module
SK6812 LEDs
Rotary encoder
Cherry MX switches
SPDT switch
USB-C connector
Voltage regulator
I2C Display module

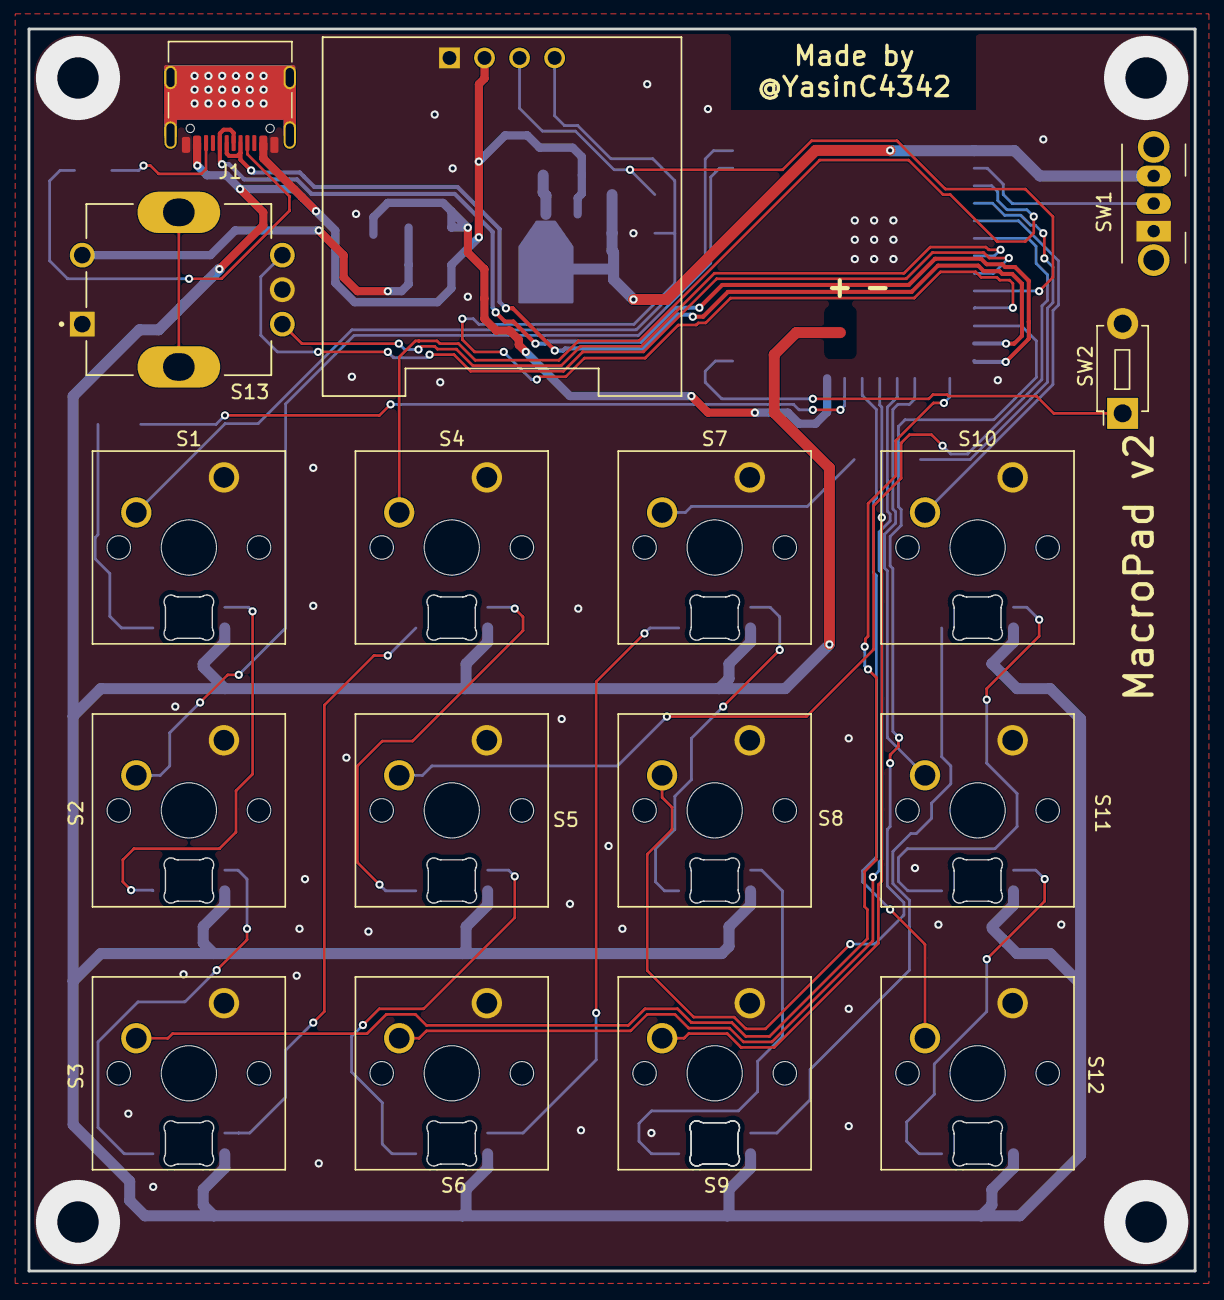
[picture p22: board BLE-MacroPad.kicad_pcb from above]

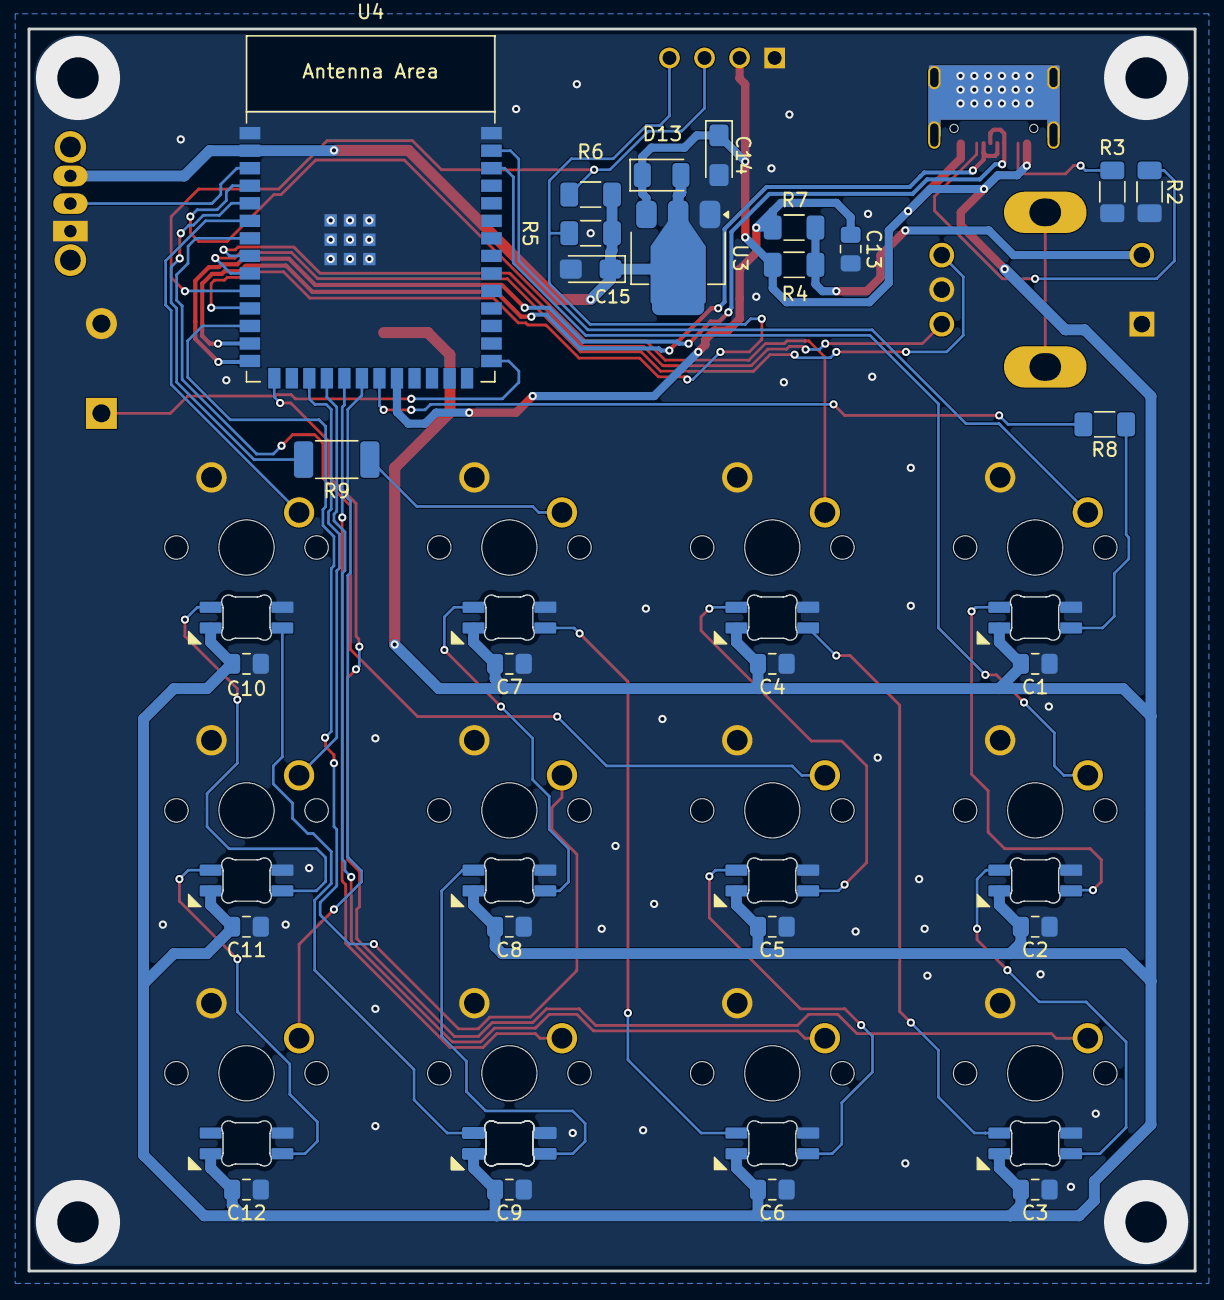
[picture p23: board BLE-MacroPad.kicad_pcb from below]

Board: 2 copper layers, 84.5 x 90.0 mm, 56 parts (26 on the bottom side), 42 nets.

Other parts of the board:
D9#2: SK6812; MX_SK6812MINI-E

Their connections:
+5V: D9#2.3 (VDD); also elsewhere on the board
GNDPWR: D9#2.1 (VSS); also elsewhere on the board
unnamed 33: D9#2.2 (DIN); also elsewhere on the board
unnamed 34: D9#2.4 (DOUT); also elsewhere on the board
