YasinC4342/BLE-MacroPad/(commit log)

2026-10-17 Add project journal for BLE-MacroPad
    Document the design process and decisions for the BLE-MacroPad project, including mechanical design, PCB design, and manufacturing preparations.
2026-10-17 Update JOURNAL.md with actual images
    Replaced placeholder image links with actual images for schematic, PCB layout, ERC, DRC, and manufacturing files.
2026-10-17 Add Fusion 360 source assembly
    [BLE-MacroPad.f3z]
2026-10-20 Remove BOM table from JOURNAL.md
    Removed detailed BOM table for components including capacitors, diodes, resistors, switches, and microcontrollers.
2026-10-20 Document cost optimization for component selection
    Updated JOURNAL.md to document component cost optimization and changes to BOM.
2026-10-20 Revise JOURNAL.md with design updates and time logs
    Updated project journal with design decisions, challenges, and total time spent for each stage. Adjusted total time and added new sections for manufacturing preparation and component cost optimization.
2026-10-20 Revise journal entries for PCB design updates
    Updated journal entries to reflect PCB design work in KiCad and corrected the title for the October 6 entry.
2026-10-20 Update project journal with recent design progress
    Updated total time spent on the project and documented progress on PCB design, manufacturing file preparation, and project status. Added detailed entries for design decisions, challenges, and next steps.
2026-10-20 Revise journal entries for macro keypad project
    Updated the journal entries to reflect the design process and decisions for the macro keypad project, including changes in PCB design, mechanical layout, and manufacturing preparation.
2026-10-20 Update project total time and add cost optimization entry
    Updated total time spent on the project and added a new journal entry for component cost optimization, including changes to the BOM and considerations for the PCB footprint.
2026-10-20 Revise PCB design and optimize BOM for cost
    Updated PCB design details and optimized component costs. Adjusted images and formatting for clarity.
2026-10-20 Revise PCB design and BOM for cost optimization
    Updated the PCB design details, including component integration and layout validation using Fusion 360. Revised BOM to optimize costs while maintaining functionality.
2026-10-20 Revise PCB design details and validation status
    Updated the PCB design details for the macro keypad, including integration of the ESP32-WROOM module and a keepout zone for the antenna. Adjusted challenges and validation status sections.
2026-10-20 Revise cost and PCB update details in JOURNAL.md
    Updated the cost details and clarified the PCB update requirements.
2026-10-21 Add prototype image to README
    Added image of the prototype to the README.
2026-10-21 Add MacroPad firmware with OLED and RGB support
    This firmware is designed for MacroPad devices, utilizing an I2C SSD1306 OLED display, rotary encoder, and RGB LEDs. It includes functionality for keyboard shortcuts and displays connection status.
    [MacroPad.ino]
2026-10-21 Fix prototype image link in README
    Updated the prototype image link in the README.
2026-10-21 Update README with project prototype link
    Added a link to the project prototype in the README.
2026-10-21 Revise BLE-MacroPad project journal entries
    Updated project journal with detailed descriptions of the BLE-MacroPad design process, including PCB and mechanical design changes, challenges faced, and design decisions. Added images for visual reference.
2026-10-21 Revise manufacturing files and BOM for v2.0.0 release
    Updated the manufacturing files for release v2.0.0, including a zip of Gerber files, BOM, and mechanical exports. Revised the BOM to fit a $50 budget by replacing the ESP32-S3-WROOM-2 with the more affordable ESP32-S3-WROOM-1 N16R8 and ensured all files are organized for publication.
2026-10-21 Revise PCB details and BOM for cost optimization
    Updated PCB design details and component cost optimization notes in JOURNAL.md.
2026-10-21 Revise BOM with updated component information
    Updated component details and links in the BOM section.
2026-10-21 Revise BOM.csv with new components and prices
    Updated BOM.csv to include new component details and pricing.
    [BOM.csv]
2026-10-21 Revise BOM with updated components and pricing
    Updated BOM.csv to reflect current components and prices, including links to suppliers.
    [BOM.csv]
2026-10-21 Clean up BOM.csv by standardizing characters
    Replaced special characters with standard characters in BOM.csv.
    [BOM.csv]
